mazetrnc/biodigestor/esquematico_biodigestor.pdf

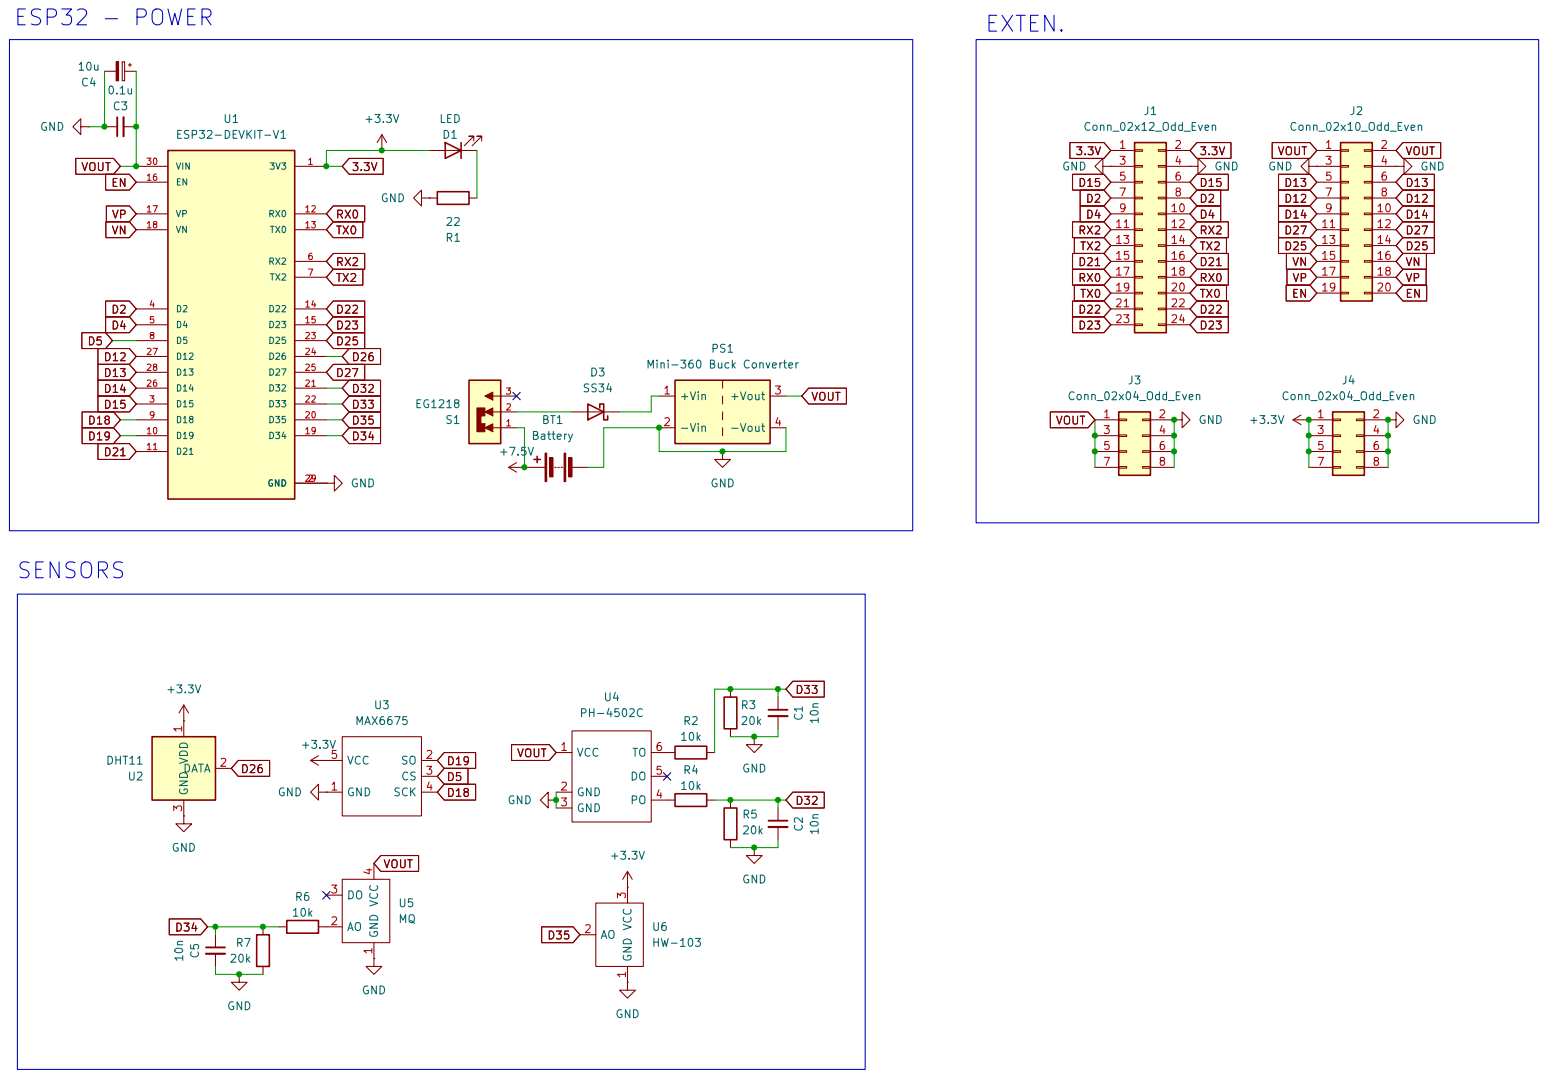
[picture p1: page 1]
