mazetrnc/biodigestor/(commit log)

2026-03-24 Enhance README with biodigester monitoring details
    Added detailed description of the biodigester monitoring system, including sensor functionalities and data transmission to ThingSpeak.
2026-03-25 Enhance README formatting with bold and images
    Added formatting for sensor descriptions and images.
2026-03-25 Modify README with updated images and sensor details
    Updated image size and improved description of pH sensor functionality.
2026-03-27 Document PCB development for system optimization
    Added a section on PCB development for system optimization, detailing design improvements and component integration.
2026-03-27 Update PCB section in README with new image
    Updated the PCB section with a new image and improved explanation of the design benefits.
2026-03-27 Replace images in README for PCB design updates
    Updated images in the README to reflect the new PCB design and improvements over the initial prototype.
2026-03-27 Update README with PCB design and schematic link
    Added a link to the schematic of the monitoring system.
2026-03-27 Update schematic link in README.md
